dgatwood/pflugelhorn/(threads)

Thread 1 (2025-08-07):

Valve slides seem to leak quite a bit.

dgatwood, 2025-08-07:
As of the current build, as soon as you push down one of the valves, the tone gets fuzzy.  This is likely an indication that the valve slides are leaking a decent amount of air because of too much tolerance.  This is probably an easy fix.

Additionally, I'm having to use a layer of masking tape around all of the bell joints, the joint between the bell and the valve segment, and the joint between the receiver and the bell segment.

And despite a lot of sanding, the valves are still sticking pretty badly.  This probably just means I need to do more sanding on the flat side, but no guarantees until it works.

The lower register is a little fuzzier than the upper register as well, which might be from leakage, or it might be an indication that the bell isn't quite perfect and needs to be slightly bigger, or it might be an error in the lead pipe internal slope (which was absolutely a guess), or it might be somehow caused by the step between the inner lead pipe and the outer lead pipe, which is caused by the plastic having to be much thicker than brass would be.

I hope to fix these in an upcoming revision.

Still, I'm shocked that after less than three weeks (I started this on July 18), I have built a 3D-printed flugelhorn that would actually kind of playable if the valves didn't keep sticking.  And my guess for the fourth valve tubing dimensions turned out to be pretty much dead on, too, despite being an absolute wild guess.  To be honest, when I started, I'd have given this only about a 30% chance of being even remotely functional.  😂

dgatwood, 2025-08-07:
After more analysis, the slides aren't what's leaking, but rather the tubing leading up to them.  I can't be certain whether it is a design problem, damage from removing the supports, or the supports inadequately supporting the model, but my guess is the third one.

I'm about to reprint with tighter top interface spacing and using breakaway PLA instead of normal PLA for the support interface, and we'll see if these problems magically go away (after a few hours of printing and another half hour of sanding the insides of the valves).

If that doesn't help, I'll have to figure out whats wrong with the model.

dgatwood, 2025-08-08:
It was a design flaw in the model.  I was subtracting cylinders to punch the holes in the valve casings, but I was doing it in such a way that it also gouged grooves in the initial curved part of the valve tubing.

The second valve was fine because it went straight out, and the fourth valve did not leak largely by accident, presumably because the supports didn't happen to touch the spots where it was thinnest.

I've fixed the problems in the model, and I'm reprinting it again.

dgatwood, 2025-08-08:
Also adjusted the various tube couplers so that they won't leak.  Will reprint the curved parts of the bell tomorrow.
