dgatwood/pflugelhorn/(commit log)

2025-08-07 Early draft of the old valve design. This didn't work because the valves were too far apart.
    [Flugelhorn.scad]
2025-08-07 A later draft while trying to get the bell working.
    [Flugelhorn.scad]
2025-08-07 Added screw plates for holding certain parts together.
    [Flugelhorn.scad]
2025-08-07 Bell, valves, and lead pipe are complete. Valves are largely functional. No valve tubing or support braces yet.
    [Flugelhorn.scad]
2025-08-07 Added more braces and corrected lead pipe dimensions.
    [Flugelhorn.scad]
2025-08-07 Added valve tubing.
    [Flugelhorn.scad]
2025-08-07 Tuning slide fixes and initial work on a spit valve.
    [Flugelhorn.scad]
2025-08-07 Additional work on spit valve.
    [Flugelhorn.scad]
2025-08-07 Additional mounting plates, minor changes to make it possible to assemble this.
    [Flugelhorn.scad]
2025-08-07 Minor fixes to receiver/tuning hardware and spit valve.
    [Flugelhorn.scad]
2025-08-07 Added couplers at various joints.
    [Flugelhorn.scad]
2025-08-07 Added coupler for receiver tubing.
    [Flugelhorn.scad]
2025-08-07 Cleanup and adding some control over what parts get rendered.
    [Flugelhorn.scad]
2025-08-07 Further splitting into groups and moving pieces down to the build plate, depending on output mode (global_build_group) selected.
    [Flugelhorn.scad]
2025-08-07 Tightened up a lot of tolerances and made the spit valve actually hold a spring without breaking.
    [Flugelhorn.scad]
2025-08-07 Additional tolerance improvements to reduce leakage, added some braces, and other minor tweaks.
    [Flugelhorn.scad]
2025-08-07 Added missing README.
    [Flugelhorn.scad]
2025-08-08 Fixed tube leaks, minor position tweaks.
    - Fixed a spot where boring holes through the valve casing also
    bored thin spots in the valve tubing, resulting in major air
    leaks from breaking away the supports.
    - Slightly increased the size of the receiver's outer tube to
    fix air leakage at that spot.
    - Fixed a bug where curved tubes had some garbage at the ends because
    the bore stopped exactly at the end of the outer tube.
    - Fixed some spots where tubes were mis-positioned by about 0.1mm.
    [Flugelhorn.scad]
2025-08-08 Tightened the couplers.
    [Flugelhorn.scad]
2025-08-08 Made the large morse receiver's outer diameter be the same as the small morse receiver's outer diameter so that you don't have to replace the valve block to change lead pipes.
    [Flugelhorn.scad]
2025-08-09 Reverted some 0.1mm changes that were wrong, and fixed a problem where curved tubes had a weak spot at the ends.
    [Flugelhorn.scad]
2025-08-09 Fixed a subtle error (and an excellent demonstration of why reusing variables in functional languages is a bad idea) that caused a previous change, originally intended to strengthen the ends, to inst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
    [Flugelhorn.scad]
2025-08-10 Fixed a bug where the bell was basically being rendered twice in place because of code previously put in place for a feature that isn't supported yet. Also added some temporary code for testing coupl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
    [Flugelhorn.scad]
2025-08-10 Fixed some typos in comments.
    [Flugelhorn.scad]
2025-08-11 Fixed a problem with the brace overlapping into the fourth valve slide, and added some overlap between the brace and the tubing.
    [Flugelhorn.scad]
2025-08-13 Lots of minor tweaks.
    - Bore the fourth valve supports with a smaller bore to avoid weakening the tubes.
    - Split the valve cores into a separate module from the valve caps, and enabled the
    valve caps in a separate global build group.
    - Split the bell part into multiple global build groups.
    - Tweaked the valve core dimensions to minimize sanding while minimizing leakage.
    - Made an option for printing the valves horizontally to see if that will further
    reduce the sanding required (by not having the lines go the same direction).
    - Created a way to reprint the top surface of the fourth valve support by itself
    because of how unreliable tree supports are.
    [Flugelhorn.scad]
2025-08-14 Thickened tuning slide walls to fix fragility. Added a temporary chunk of code to let me print part of the slides so I can work out some of the 3D printing parameters on the slicer side. For context,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
    [Flugelhorn.scad]
2025-08-14 Updated documentation.
    [Flugelhorn.scad]
2025-08-15 Added a global tuning slide gap to allow for tightening it up.
    [Flugelhorn.scad]
2025-08-15 Tweaked tuning slide gap, and fliped the frowns^H^H^H^H^H^Hslides upside down to reduce filament waste and hassle removing the supports.
    [Flugelhorn.scad]
2025-08-17 Made extra holes in the measurement casing, added a separate adjustment for trimming the flat side of the valve core, and started working on figuring out the best values for the valve core dimension 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
    [Flugelhorn.scad]
2025-08-18 Improved documentation, possibly final valve size.
    [Flugelhorn.scad]
2025-09-04 Made some improvements to the valve printing configuration and increased the bore through the valves to improve playability. I wouldn't call it playable yet, but it does at least have harmonics when 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
2025-09-04 Added a build group for messing with the valve design.
2025-09-04 Adjusted valve core bores to further improve air flow.
2025-09-15 New experimental valve design that avoids curvature of tubes when open.
2025-09-15 Reversed the flow of the valves to be a better match for the tubing.
